polancan/esp32-wifi-timer/04_HARDWARE/SCHEMATICS_REFERENCE/schéma_zapojení_8kanálové_wi_fi_časomíry.png

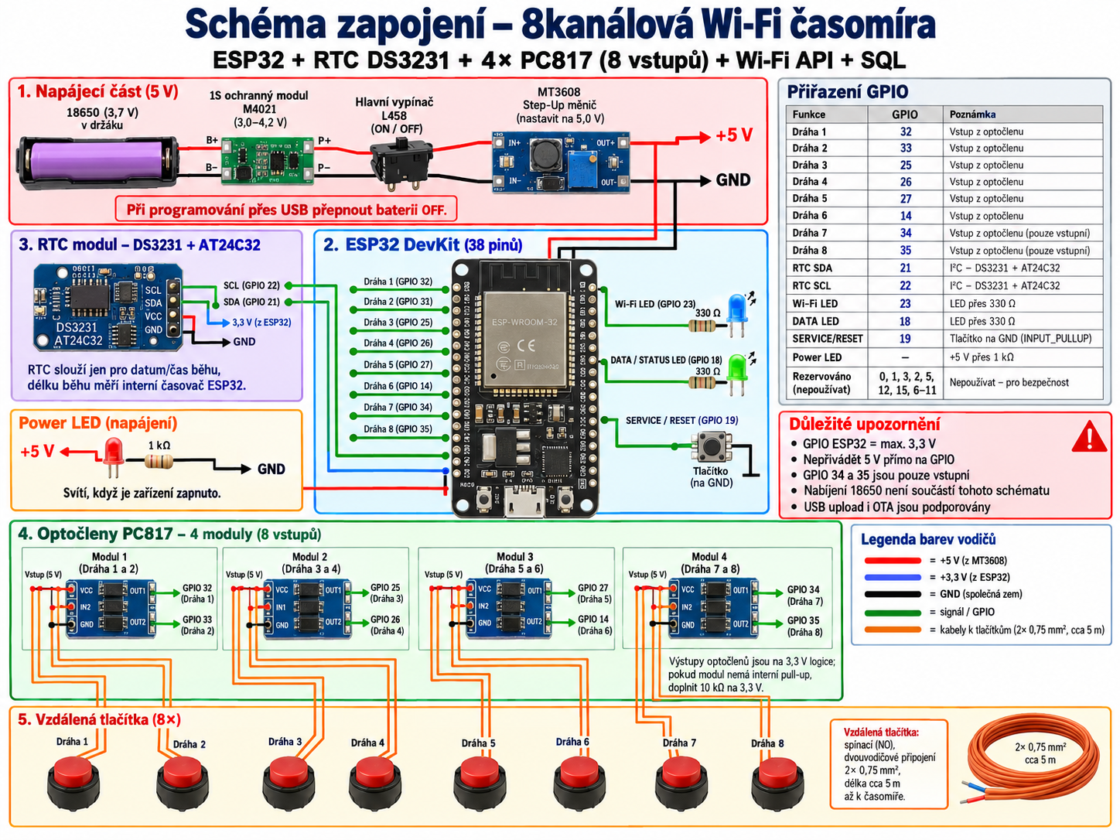
04_HARDWARE/SCHEMATICS_REFERENCE/schéma_zapojení_8kanálové_wi_fi_časomíry.png
