polancan/esp32-wifi-timer/04_HARDWARE/SCHEMATICS_REFERENCE/a_detailed_schematic_infographic_on_a_white_backgr.png

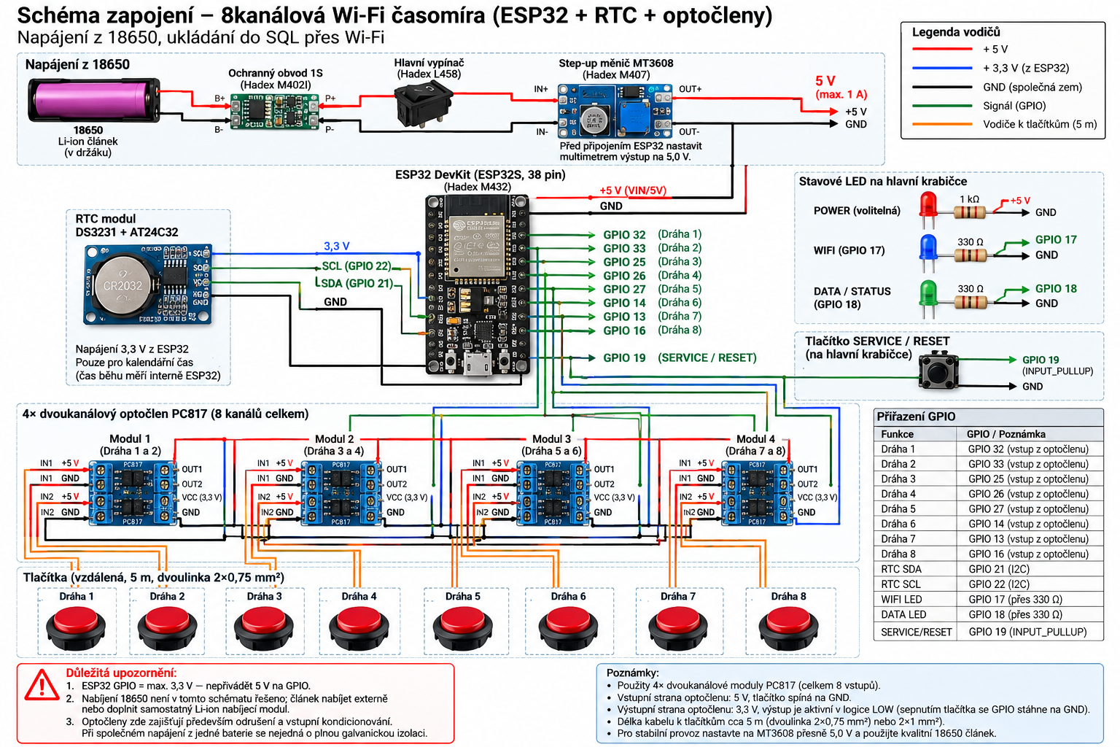
04_HARDWARE/SCHEMATICS_REFERENCE/a_detailed_schematic_infographic_on_a_white_backgr.png
