polancan/esp32-wifi-timer/02_FIRMWARE/README_FIRMWARE.md

# Firmware v1.3.1

Aktuální zdroj je v `SOURCE_v1.3.1/ESP32_Timer_Arduino/ESP32_Timer_Arduino.ino`.
Dokumentace: `../05_DOCUMENTATION/04_FIRMWARE_FLASHING.md`.

LittleFS se nepoužívá; offline výsledek je uložen v Preferences/NVS.
