polancan/esp32-wifi-timer/03_3D/README_3D.md

# 3D V1.7

Aktuální mechanika: PG7, hlavní zadní stěna 8× 12,5 mm.
GX16/M12 zatím není rozhodnuto. Finální materiál PETG.
Viz `../05_DOCUMENTATION/08_3D_MODELS.md`.
