polancan/esp32-wifi-timer/04_HARDWARE/PCB_REV_B_INTEGRATED/NETS.csv

Net | Pins | Domain | Note
USB_VBUS | J_USB.VBUS F_USB U_CHG.VBUS U_UART.VBUS | LOGIC | Never short to boosted 5V
USB_DP | J_USB.DP_A J_USB.DP_B D_USB U_UART.D+ | LOGIC | BQ25606 D+ remains NC
USB_DN | J_USB.DN_A J_USB.DN_B D_USB U_UART.D- | LOGIC | BQ25606 D- remains NC
USB_CC1 | J_USB.CC1 U_CC.CC1 | LOGIC | TUSB320I UFP termination
USB_CC2 | J_USB.CC2 U_CC.CC2 | LOGIC | TUSB320I UFP termination
BAT_PLUS | J_BAT.1 U_CHG.BAT R_BAT1.1 | LOGIC | Protected cell positive; exact pin depends connector
BAT_NTC | J_BAT.3 U_CHG.TS via bias network | LOGIC | Sensor bonded to battery
SYS | U_CHG.SYS U_3V3.VIN U_5V.VIN | LOGIC | 3.5-4.6V power path
LOGIC_GND | J_USB.GND J_BAT.2 U_CHG.GND U_3V3.GND U_5V.GND U_ESP.GND U_UART.GND U_RTC.GND | LOGIC | Must not join FIELD_GND
V3V3 | U_3V3.VOUT U_ESP.3V3 U_UART.VIO U_RTC.VCC J_EXP.1 R_PULL1-8.1 R_I2C1-2.1 | LOGIC | Wi-Fi current transient check
V5_LOGIC | U_5V.VOUT U_ISO.+VIN | LOGIC | Never short to USB VBUS
FIELD_5V | U_ISO.+VOUT U_FIELD.VIN | FIELD | Separate domain
FIELD_GND | U_ISO.-VOUT U_FIELD.GND U_OPTO1-8.LED_K | FIELD | Separate domain
FIELD_12_24V | U_FIELD.VOUT F_FIELD.IN | FIELD | Adjust 12-24V; clamp/limit requirement
FIELD_FUSED | F_FIELD.OUT J_LANE1-8.1 | FIELD | Eight contact outgoing terminals
BAT_ADC | R_BAT1.2 R_BAT2.1 C_BAT.1 U_ESP.GPIO36 | LOGIC | 100k/100k divider
I2C_SDA | U_ESP.GPIO21 U_RTC.SDA R_I2C1.2 | LOGIC | 3.3V
I2C_SCL | U_ESP.GPIO22 U_RTC.SCL R_I2C2.2 | LOGIC | 3.3V
UART_TX0 | U_ESP.GPIO1 U_UART.RXD | LOGIC | ESP transmitter
UART_RX0 | U_UART.TXD U_ESP.GPIO3 | LOGIC | ESP receiver
BOOT_EN | U_ESP.EN SW_RESET auto-program Q network | LOGIC | 10k to 3V3 and >=1uF to ground
BOOT_IO0 | U_ESP.GPIO0 SW_BOOT J_EXP.8 auto-program Q network | LOGIC | 10k pullup; strap
SERVICE | U_ESP.GPIO19 SW_SERVICE.1 | LOGIC | SW other pin ground
LED_WIFI | U_ESP.GPIO23 LED_WIFI.series_R | LOGIC | Active high
LED_DATA | U_ESP.GPIO18 LED_DATA.series_R | LOGIC | Active high
LANE1_RETURN | J_LANE1.2 R_LANE1.1 | FIELD | Dry contact return
LANE1_LED_A | R_LANE1.2 U_OPTO1.LED_A D_LANE1.K | FIELD | Reverse diode antiparallel
LANE1_GPIO | U_OPTO1.COLLECTOR R_PULL1.2 U_ESP.GPIO32 | LOGIC | Pressed LOW; emitter to LOGIC_GND
LANE2_RETURN | J_LANE2.2 R_LANE2.1 | FIELD | Dry contact return
LANE2_LED_A | R_LANE2.2 U_OPTO2.LED_A D_LANE2.K | FIELD | Reverse diode antiparallel
LANE2_GPIO | U_OPTO2.COLLECTOR R_PULL2.2 U_ESP.GPIO33 | LOGIC | Pressed LOW; emitter to LOGIC_GND
LANE3_RETURN | J_LANE3.2 R_LANE3.1 | FIELD | Dry contact return
LANE3_LED_A | R_LANE3.2 U_OPTO3.LED_A D_LANE3.K | FIELD | Reverse diode antiparallel
LANE3_GPIO | U_OPTO3.COLLECTOR R_PULL3.2 U_ESP.GPIO25 | LOGIC | Pressed LOW; emitter to LOGIC_GND
LANE4_RETURN | J_LANE4.2 R_LANE4.1 | FIELD | Dry contact return
LANE4_LED_A | R_LANE4.2 U_OPTO4.LED_A D_LANE4.K | FIELD | Reverse diode antiparallel
LANE4_GPIO | U_OPTO4.COLLECTOR R_PULL4.2 U_ESP.GPIO26 | LOGIC | Pressed LOW; emitter to LOGIC_GND
LANE5_RETURN | J_LANE5.2 R_LANE5.1 | FIELD | Dry contact return
LANE5_LED_A | R_LANE5.2 U_OPTO5.LED_A D_LANE5.K | FIELD | Reverse diode antiparallel
LANE5_GPIO | U_OPTO5.COLLECTOR R_PULL5.2 U_ESP.GPIO27 | LOGIC | Pressed LOW; emitter to LOGIC_GND
LANE6_RETURN | J_LANE6.2 R_LANE6.1 | FIELD | Dry contact return
LANE6_LED_A | R_LANE6.2 U_OPTO6.LED_A D_LANE6.K | FIELD | Reverse diode antiparallel
LANE6_GPIO | U_OPTO6.COLLECTOR R_PULL6.2 U_ESP.GPIO14 | LOGIC | Pressed LOW; emitter to LOGIC_GND
LANE7_RETURN | J_LANE7.2 R_LANE7.1 | FIELD | Dry contact return
LANE7_LED_A | R_LANE7.2 U_OPTO7.LED_A D_LANE7.K | FIELD | Reverse diode antiparallel
LANE7_GPIO | U_OPTO7.COLLECTOR R_PULL7.2 U_ESP.GPIO34 | LOGIC | Pressed LOW; emitter to LOGIC_GND
LANE8_RETURN | J_LANE8.2 R_LANE8.1 | FIELD | Dry contact return
LANE8_LED_A | R_LANE8.2 U_OPTO8.LED_A D_LANE8.K | FIELD | Reverse diode antiparallel
LANE8_GPIO | U_OPTO8.COLLECTOR R_PULL8.2 U_ESP.GPIO35 | LOGIC | Pressed LOW; emitter to LOGIC_GND
GPIO4_EXP | U_ESP.GPIO4 J_EXP.3 | LOGIC | Free GPIO
GPIO13_EXP | U_ESP.GPIO13 J_EXP.4 | LOGIC | Free GPIO
GPIO16_EXP | U_ESP.GPIO16 J_EXP.5 | LOGIC | Free GPIO
GPIO17_EXP | U_ESP.GPIO17 J_EXP.6 | LOGIC | Free GPIO
GPIO39_EXP | U_ESP.GPIO39 J_EXP.7 | LOGIC | Input only
GPIO0_EXP | U_ESP.GPIO0 J_EXP.8 | LOGIC | Boot strap
GPIO2_EXP | U_ESP.GPIO2 J_EXP.9 | LOGIC | Boot strap
GPIO5_EXP | U_ESP.GPIO5 J_EXP.10 | LOGIC | Boot strap
GPIO12_EXP | U_ESP.GPIO12 J_EXP.11 | LOGIC | Boot strap
GPIO15_EXP | U_ESP.GPIO15 J_EXP.12 | LOGIC | Boot strap
CC_OUT1 | U_CC.OUT1 U_ILIMLOGIC.IN1 | LOGIC | Current advertisement mode
CC_OUT2 | U_CC.OUT2 U_ILIMLOGIC.IN2 | LOGIC | Current advertisement mode
CHG_ILIM | U_ILIMLOGIC.OUT U_CHG.ILIM | LOGIC | Safe default current limit pending circuit
POWER_EN | SW_MAIN U_3V3.EN U_5V.EN | LOGIC | System off leaves charger attached to BAT; EN polarity to verify
