polancan/esp32-wifi-timer/04_HARDWARE/PCB_REV_A/NETS.csv

Net | Spoje | Domena | Poznamka
BAT_PLUS | BT1.plus|SW1.in|R_BAT_TOP.1 | LOGIC | merit pred boostem
BAT_SW | SW1.out|U_5V.vin | LOGIC | pojisteni clanku dle finalniho navrhu
GND_LOGIC | BT1.minus|U_5V.gnd|MOD_ESP.GND|U_ISO.pin2|U_ISO.pin3|U1-U8.emitor|R_BAT_BOTTOM.2|C_BAT.2|RTC1.GND|CI_ISO.minus | LOGIC | bez spoje na F_GND
V5_LOGIC | U_5V.vout|MOD_ESP.VIN_5V|U_ISO.pin22|U_ISO.pin23|CI_ISO.plus | LOGIC | USB or-ing vyresit v finalnim schematu
V3V3 | MOD_ESP.3V3|RP1-RP8.1|RTC1.VCC|R_SDA.1|R_SCL.1 | LOGIC | RTC I2C pull-up jen na 3V3
V5_FIELD | U_ISO.pin14|U_FIELD.vin|CO_ISO.plus | FIELD | izolovana 5V vetev
F_GND | U_ISO.pin16|U_FIELD.gnd|U1-U8.LED_K|D1-D8.A|TP_FGND|C_FIELD.minus|CO_ISO.minus|T1-T8.2 | FIELD | izolovana zem
F_FIELD_PLUS | U_FIELD.vout|F_FIELD.in|TP_F24|C_FIELD.plus | FIELD | pred jistenim
F_FIELD_FUSED | F_FIELD.out|J1-J8.pin1 | FIELD | 12 az 24V do kabelu
LANE1_RETURN | J1.pin2|R1.1|T1.1 | FIELD | TVS T1 DNP
LANE2_RETURN | J2.pin2|R2.1|T2.1 | FIELD | TVS T2 DNP
LANE3_RETURN | J3.pin2|R3.1|T3.1 | FIELD | TVS T3 DNP
LANE4_RETURN | J4.pin2|R4.1|T4.1 | FIELD | TVS T4 DNP
LANE5_RETURN | J5.pin2|R5.1|T5.1 | FIELD | TVS T5 DNP
LANE6_RETURN | J6.pin2|R6.1|T6.1 | FIELD | TVS T6 DNP
LANE7_RETURN | J7.pin2|R7.1|T7.1 | FIELD | TVS T7 DNP
LANE8_RETURN | J8.pin2|R8.1|T8.1 | FIELD | TVS T8 DNP
LANE1_LED_A | R1.2|U1.LED_A|D1.K | FIELD | D1 antiparalelne
LANE2_LED_A | R2.2|U2.LED_A|D2.K | FIELD | D2 antiparalelne
LANE3_LED_A | R3.2|U3.LED_A|D3.K | FIELD | D3 antiparalelne
LANE4_LED_A | R4.2|U4.LED_A|D4.K | FIELD | D4 antiparalelne
LANE5_LED_A | R5.2|U5.LED_A|D5.K | FIELD | D5 antiparalelne
LANE6_LED_A | R6.2|U6.LED_A|D6.K | FIELD | D6 antiparalelne
LANE7_LED_A | R7.2|U7.LED_A|D7.K | FIELD | D7 antiparalelne
LANE8_LED_A | R8.2|U8.LED_A|D8.K | FIELD | D8 antiparalelne
GPIO32 | U1.kolektor|RP1.2|MOD_ESP.GPIO32 | LOGIC | draha 1 aktivni LOW
GPIO33 | U2.kolektor|RP2.2|MOD_ESP.GPIO33 | LOGIC | draha 2 aktivni LOW
GPIO25 | U3.kolektor|RP3.2|MOD_ESP.GPIO25 | LOGIC | draha 3 aktivni LOW
GPIO26 | U4.kolektor|RP4.2|MOD_ESP.GPIO26 | LOGIC | draha 4 aktivni LOW
GPIO27 | U5.kolektor|RP5.2|MOD_ESP.GPIO27 | LOGIC | draha 5 aktivni LOW
GPIO14 | U6.kolektor|RP6.2|MOD_ESP.GPIO14 | LOGIC | draha 6 aktivni LOW
GPIO34 | U7.kolektor|RP7.2|MOD_ESP.GPIO34 | LOGIC | draha 7 aktivni LOW
GPIO35 | U8.kolektor|RP8.2|MOD_ESP.GPIO35 | LOGIC | draha 8 aktivni LOW
BAT_ADC | R_BAT_TOP.2|R_BAT_BOTTOM.1|MOD_ESP.GPIO36|C_BAT.1 | LOGIC | C_BAT volitelny
I2C_SDA | MOD_ESP.GPIO21|RTC1.SDA|R_SDA.2 | LOGIC | pull-up na 3V3 jen jednou
I2C_SCL | MOD_ESP.GPIO22|RTC1.SCL|R_SCL.2 | LOGIC | pull-up na 3V3 jen jednou
LED_WIFI | MOD_ESP.GPIO23|LED_WIFI.vstup | LOGIC | dle firmware a zapojeni LED
LED_DATA | MOD_ESP.GPIO18|LED_DATA.vstup | LOGIC | dle firmware a zapojeni LED
SERVICE | MOD_ESP.GPIO19|SW_SERVICE.vstup | LOGIC | overit klidovy stav
