polancan/esp32-wifi-timer/04_HARDWARE/hadex_casomira_KOMPLET.csv

M351 | 4
M407 | 1
M402I | 1
O275 | 16
N125C | 45
L458 | 1
L249E | 1
K269 | 1
K121 | 1
K117 | 1
H931 | 2
H937 | 1
H537U | 1
S018B | 1
I502 | 2
I857 | 1
