polancan/esp32-wifi-timer/04_HARDWARE/hadex_casomira_MINIMUM.csv

M351 | 4
M407 | 1
M402I | 1
O275 | 16
N125C | 45
L458 | 1
