polancan/esp32-wifi-timer/04_HARDWARE/SCHEMATICS_REFERENCE/blokové_schéma_wi_fi_časomíry.png

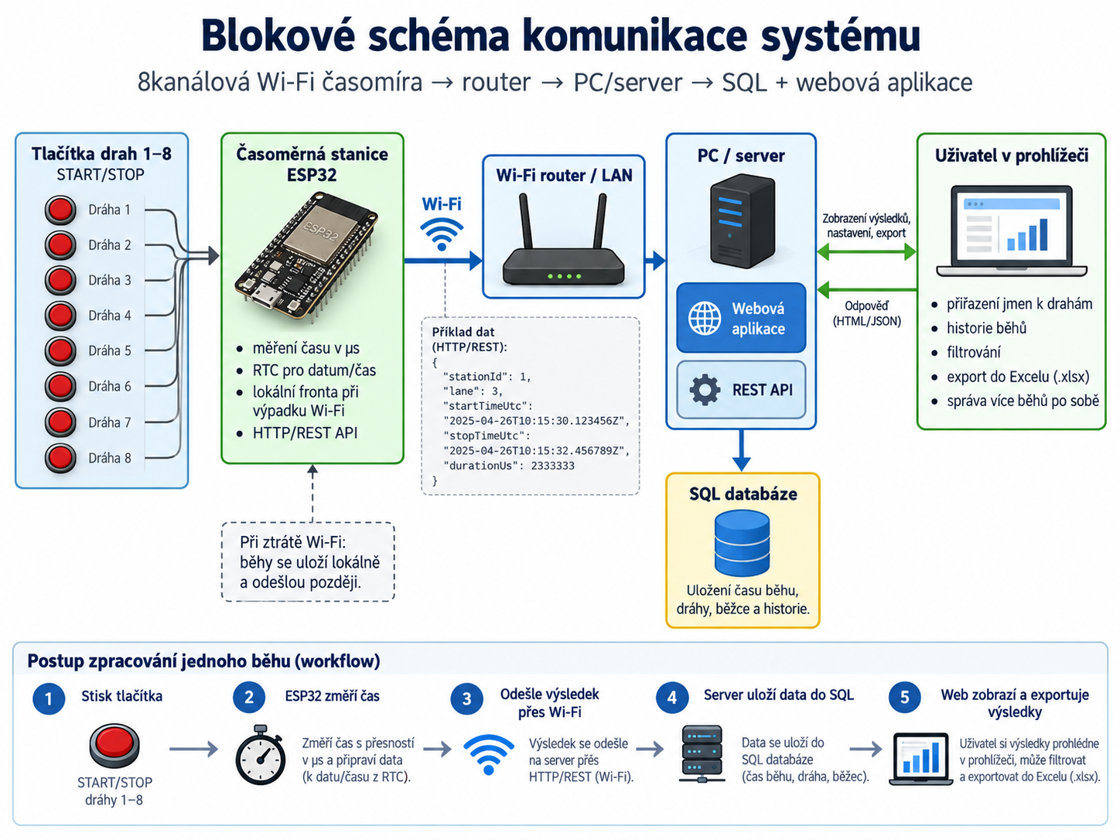
04_HARDWARE/SCHEMATICS_REFERENCE/blokové_schéma_wi_fi_časomíry.png
