polancan/esp32-wifi-timer/04_HARDWARE/SCHEMATICS_REFERENCE/stopky_esp32_s_8_drahami.png

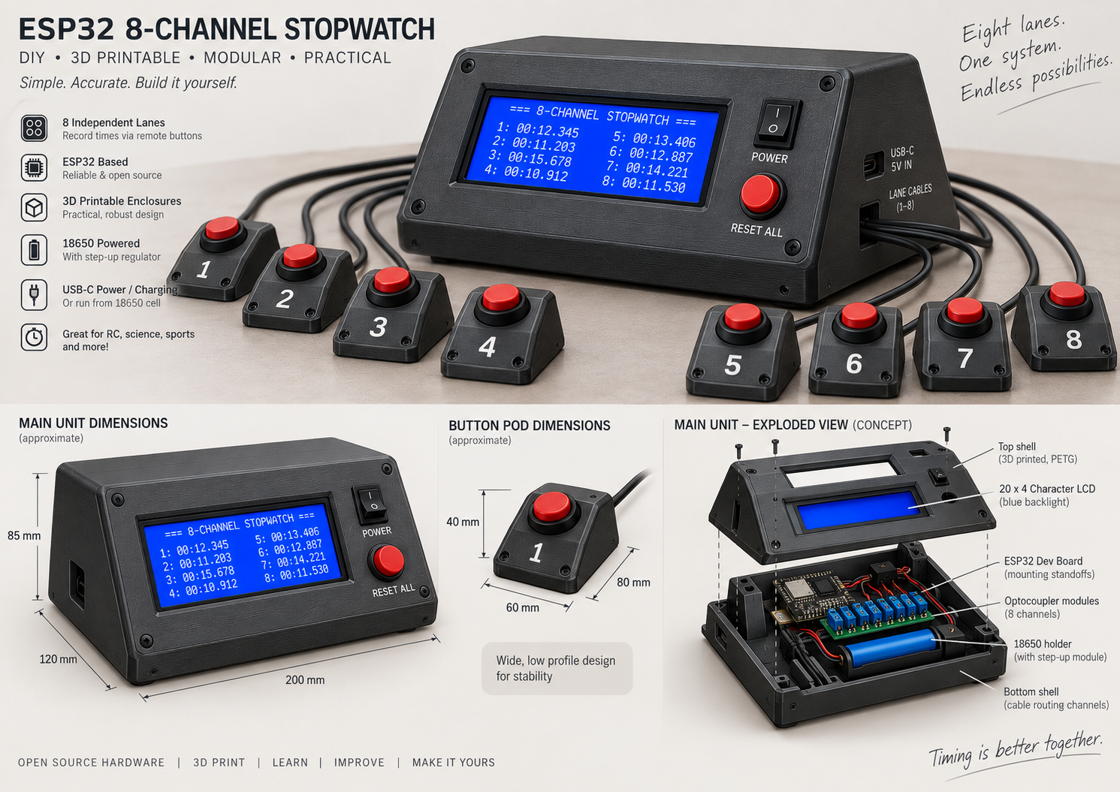
04_HARDWARE/SCHEMATICS_REFERENCE/stopky_esp32_s_8_drahami.png
