polancan/esp32-wifi-timer/05_DOCUMENTATION/UI_REFERENCE/selected_clean_layout_reference.png

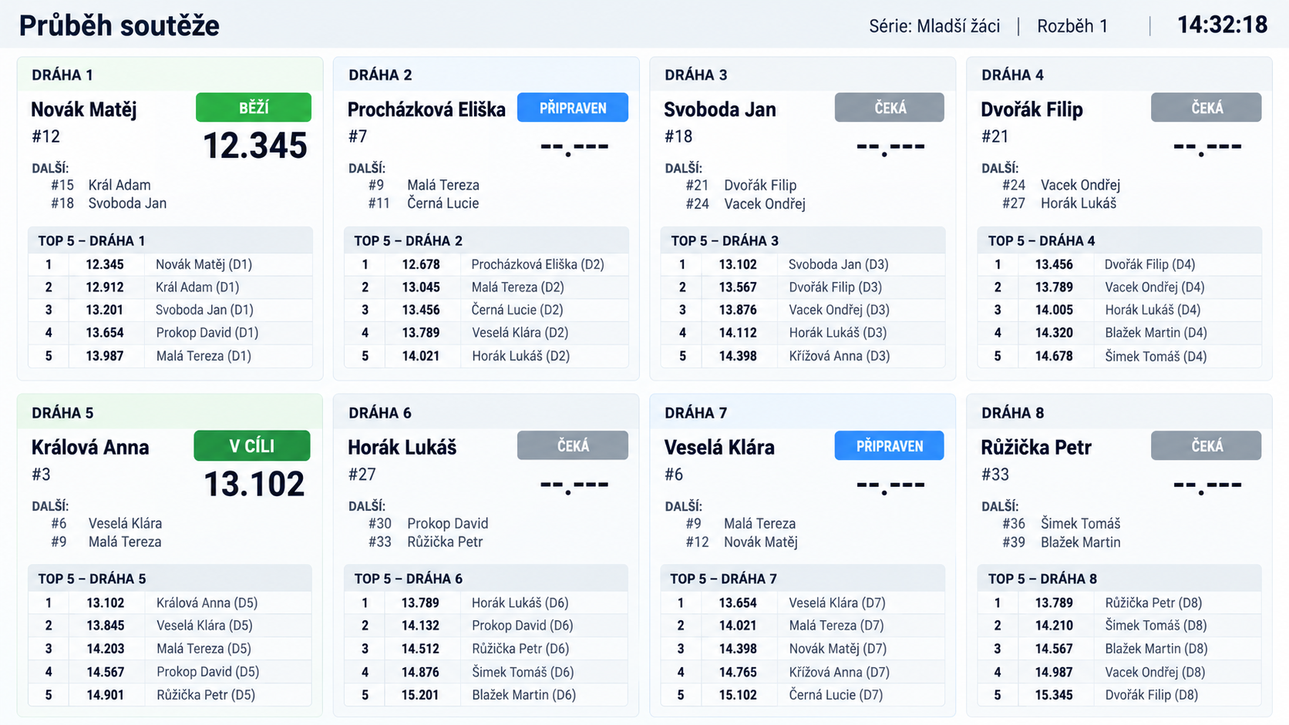
05_DOCUMENTATION/UI_REFERENCE/selected_clean_layout_reference.png
