polancan/esp32-wifi-timer/05_DOCUMENTATION/UI_REFERENCE/ui_variants_reference.png

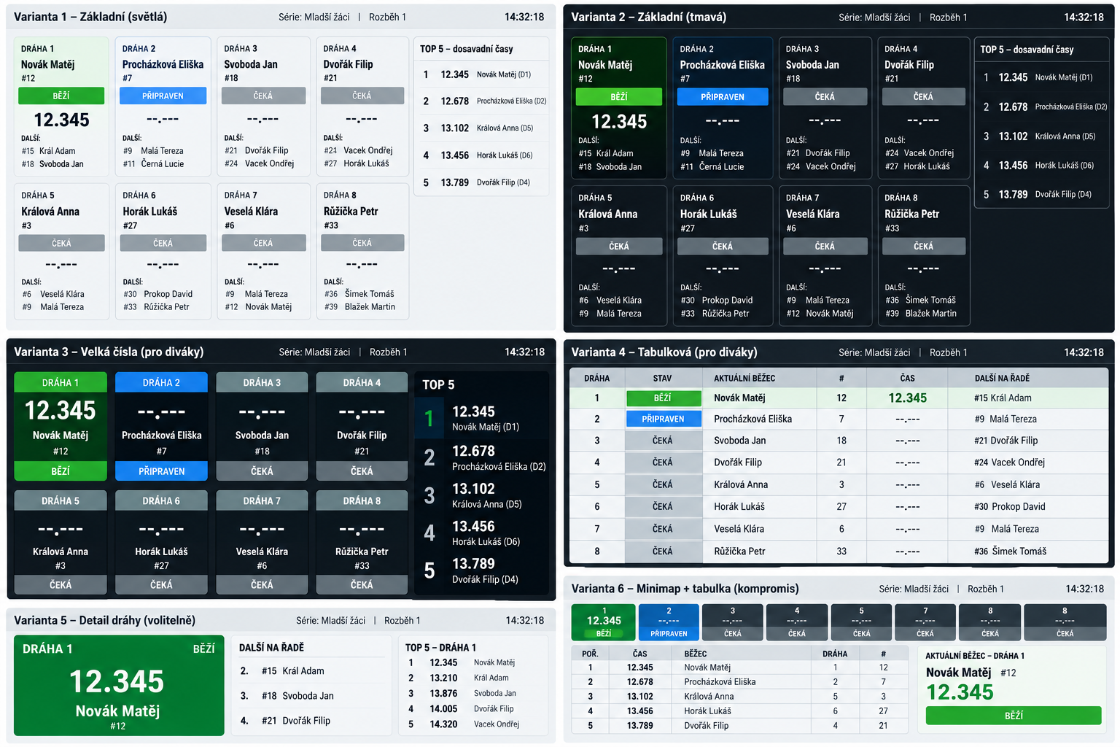
05_DOCUMENTATION/UI_REFERENCE/ui_variants_reference.png
