polancan/esp32-wifi-timer/04_HARDWARE/PCB_REV_B_INTEGRATED/BOM.csv

Ref | Qty | Part | Package | Status | DesignNote
J_USB | 1 | USB4085-GF-A | USB-C USB2.0 right-angle | CANDIDATE | Front edge; exact footprint/cutout required
U_CC | 1 | TUSB320IRWBR | X2QFN-12 | CANDIDATE | UFP Type-C CC current detection; VDD from USB VBUS independent of SW_MAIN; no PD
U_ILIMLOGIC | 1 | dual gate/analog switch network | TBD | DESIGN | OUT1/OUT2 safe ILIM selection default/1.5A/3A
D_USB | 1 | USB2.0 low-capacitance ESD array | TBD | SELECT | Protect D+ D- and CC
F_USB | 1 | USB VBUS input protection | TBD | SELECT | Coordinate with 500mA current limit and inrush
U_CHG | 1 | BQ25606RGET | VQFN-24 | CANDIDATE | 1S power-path charger; D+ D- charger pins floating
L_CHG | 1 | 1uH >= charger peak current | TBD | DESIGN | Select via TI datasheet and measured current
R_ILIM_NETWORK | 3 | TBD | 0603 | DESIGN | Select conservative USB input limits from TUSB320 OUT1/OUT2
R_ICHG | 1 | TBD | 0603 | DESIGN | Calculate for cell and system load
R_TS | 2 | TBD | 0603 | DESIGN | Thermistor bias network per NTC and TI window
J_BAT | 1 | keyed 3-pin >=3A | TBD | SELECT | Protected 18650 B+ B- NTC
SW_MAIN | 1 | latching low-current switch | TBD | SELECT | Controls regulator EN; charging remains active while off
BT1 | 1 | protected 18650 with 10k NTC | off-board | USER_PART | Cell selection/current/thermal data needed
U_3V3 | 1 | TPS63070 | VQFN | CANDIDATE | SYS to regulated 3.3V; reference design required
L_3V3 | 1 | TBD | TBD | DESIGN | Buck-boost magnetic
U_5V | 1 | TPS61088 | VQFN-20 | CANDIDATE | SYS to 5V >=1A
L_5V | 1 | TBD | TBD | DESIGN | Current saturation and efficiency verification
U_ISO | 1 | REC5-0505SRW/H4/A | DIP-24 | CANDIDATE | 5V/5V isolated 5W; footprint and EMC filter
U_FIELD | 1 | TPS55340RTE | WQFN-16 | CANDIDATE | Isolated 5V to adjustable 12-24V
L_FIELD | 1 | TBD | TBD | DESIGN | From 24V EVM but recalc 12-24V range
D_FIELD | 1 | 40V Schottky >= load | TBD | DESIGN | TPS55340 boost diode
RV_FIELD | 1 | 11k multiturn trimmer + 10k bottom + 187k top | TBD | DESIGN | Candidate 12.2-24.2V divider; tie wiper to used end, verify fault behavior
F_FIELD | 1 | field bus fuse/current limiter | TBD | DESIGN | Direct field short protection
U_ESP | 1 | ESP32-WROOM-32E-N4 | module 18x25.5mm | CHOSEN | Soldered module; antenna keepout
U_UART | 1 | CP2102N-A02-GQFN28 | QFN-28 | CANDIDATE | USB2.0 UART DTR RTS for auto boot
Q_BOOT1-Q_BOOT2 | 2 | NPN transistor per Espressif DevKitC | SOT-23 | DESIGN | Correct DTR/RTS truth table
SW_BOOT-SW_RESET | 2 | momentary tactile | TBD | SELECT | GPIO0 and EN to ground
U_RTC | 1 | DS3231SN | SOIC-16 300mil | CANDIDATE | 3.3V I2C with coin backup
BT_RTC | 1 | CR2032 holder + cell | TBD | SELECT | VBAT only; no charge path
R_I2C1-R_I2C2 | 2 | 4.7k 1% | 0603 | VALUE_SET | One pull-up per I2C line to 3.3V
LED_WIFI-LED_DATA | 2 | status LED | 0603 | SELECT | Active high via current-limit resistor
SW_SERVICE | 1 | momentary tactile | TBD | SELECT | GPIO19 to GND
U_OPTO1-U_OPTO8 | 8 | EL817C-G | DIP-4 | CANDIDATE | One per lane; verify CTR at 12V
R_LANE1-R_LANE8 | 8 | 2.2k 0.5W | 1206 or larger | VALUE_SET | At 24V approx 0.236W; thermal check
R_PULL1-R_PULL8 | 8 | 10k | 0603 | VALUE_SET | GPIO pullups 3.3V
D_LANE1-D_LANE8 | 8 | 1N4148 | SOD-123 | VALUE_SET | Antiparallel opto LED
J_LANE1-J_LANE8 | 8 | 2-pin 3.5mm terminal | TBD | SELECT | Eight dry-contact cable pairs
J_EXP | 1 | 2x7 2.54mm header | THT | CHOSEN | Unused GPIO breakout incl boot pins
R_BAT1-R_BAT2 | 2 | 100k | 0603 | VALUE_SET | Battery ADC divider GPIO36
C_BAT | 1 | 100nF | 0603 | PROVISIONAL | ADC low-pass; measure settling
TP_TEST | 8 | testpoint | TBD | DESIGN | USB5 SYS BAT 3V3 5V field5 field24 fieldGND
