polancan/esp32-wifi-timer/03_3D/STL_PRINT_ONLY_V1.7/main_tray_v1_7.stl

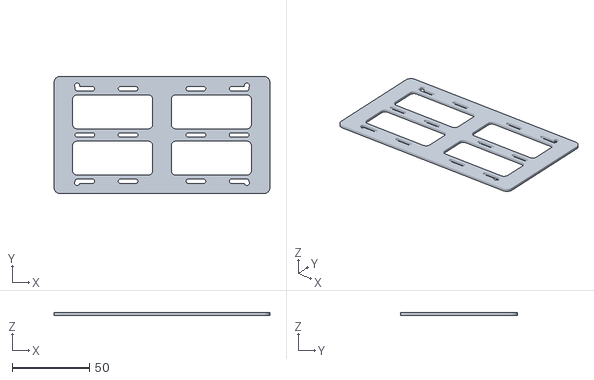
[picture p7: CAD file, 2026-10-10]
03_3D/STL_PRINT_ONLY_V1.7/main_tray_v1_7.stl
140.0 x 76.0 x 1.80
