polancan/esp32-wifi-timer/03_3D/SOURCE_V1.7/stopwatch_3d_models_v1_7_source/STL/main_lid_v1_7.stl

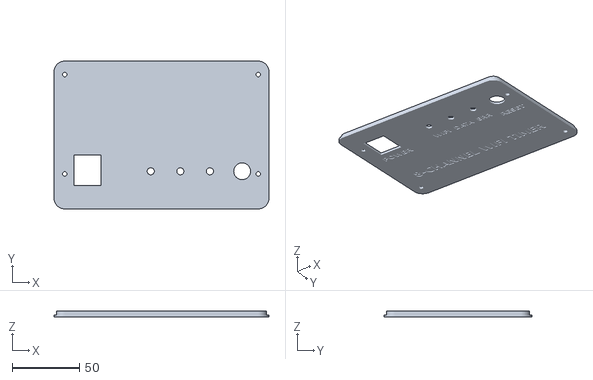
[picture p8: CAD file, 2026-10-10]
03_3D/SOURCE_V1.7/stopwatch_3d_models_v1_7_source/STL/main_lid_v1_7.stl
160.0 x 110.0 x 4.80
