polancan/esp32-wifi-timer/03_3D/STL_PRINT_ONLY_V1.7/main_base_v1_7.stl

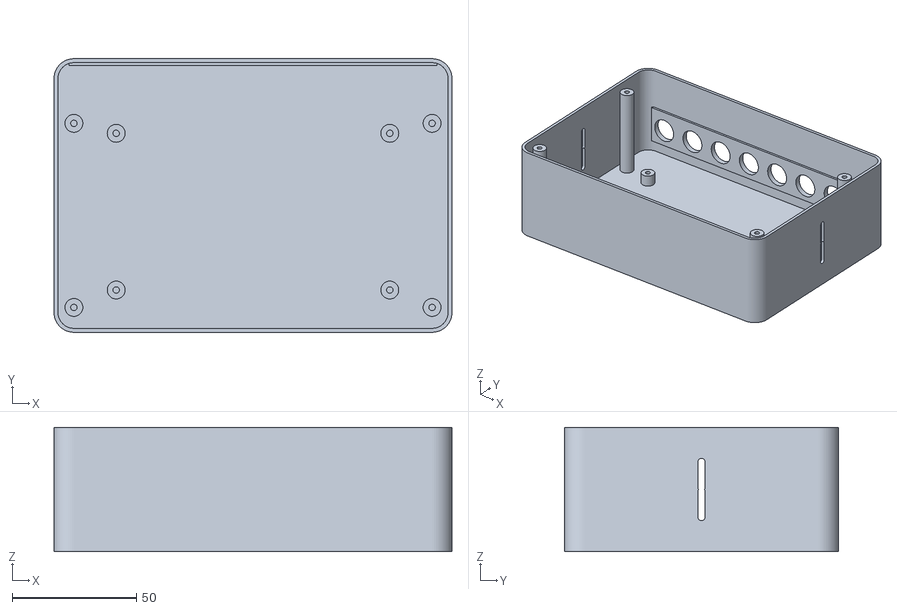
[picture p9: CAD file, 2026-10-10]
03_3D/STL_PRINT_ONLY_V1.7/main_base_v1_7.stl
160.0 x 110.0 x 50.0
