polancan/esp32-wifi-timer/03_3D/SOURCE_V1.7/stopwatch_3d_models_v1_7_source/STL/button_lid_lane5_v1_7.stl

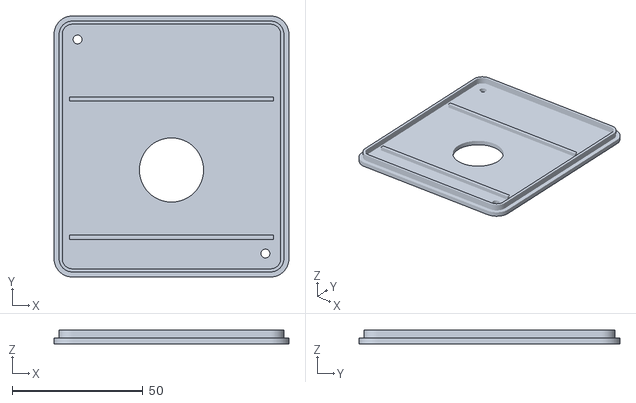
[picture p10: CAD file, 2026-10-10]
03_3D/SOURCE_V1.7/stopwatch_3d_models_v1_7_source/STL/button_lid_lane5_v1_7.stl
90.0 x 100.0 x 5.20
