polancan/esp32-wifi-timer/03_3D/STL_PRINT_ONLY_V1.7/button_base_lane2_v1_7.stl

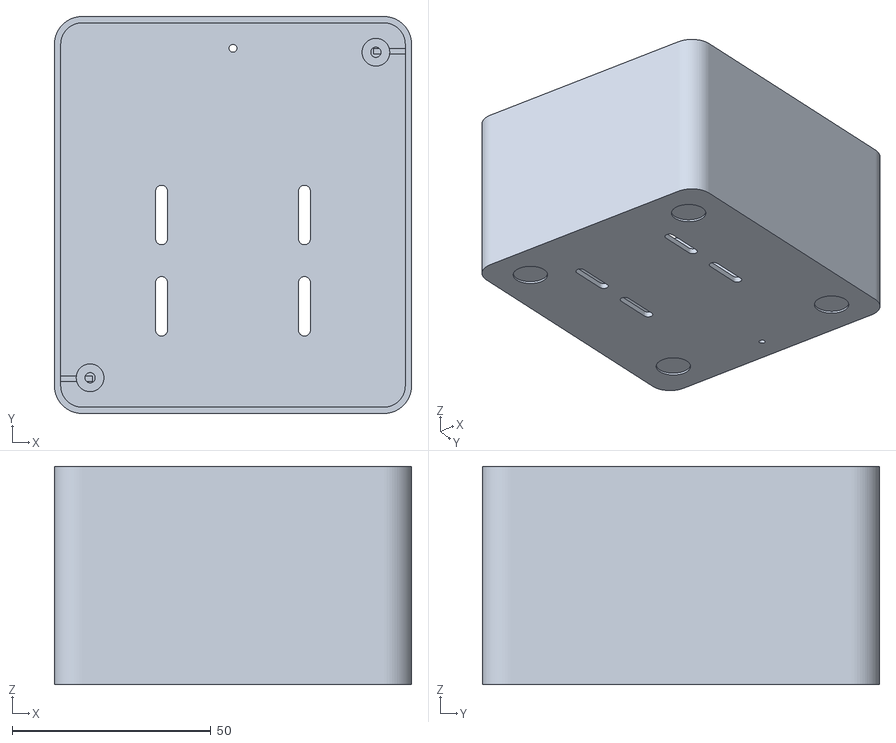
[picture p11: CAD file, 2026-10-10]
03_3D/STL_PRINT_ONLY_V1.7/button_base_lane2_v1_7.stl
90.0 x 100.0 x 55.0
