polancan/esp32-wifi-timer/03_3D/SOURCE_V1.7/stopwatch_3d_models_v1_7_source/Reference/collision_check_v1_7.scad

include <../stopwatch_enclosures_v1_7.scad>
if (TEST=="button") intersection(){ button_base(); translate([0,0,bh]) button_lid_assembly(1,false); }
else if (TEST=="main") intersection(){ main_base(); translate([0,0,mh]) main_lid_assembly(false); }
