polancan/esp32-wifi-timer/03_3D/SOURCE_V1.7/stopwatch_3d_models_v1_7_source/Reference/main_assembly_v1_7.scad

include <../stopwatch_enclosures_v1_7.scad>
main_base();
translate([0,0,mh]) main_lid_assembly(false);
translate([10,10,floor_t+6]) main_tray();
