polancan/esp32-wifi-timer/(list of files, cad)

Other CAD files:
03_3D/STL_PRINT_ONLY_V1.7/button_lid_lane1_v1_7.stl
03_3D/SOURCE_V1.7/stopwatch_3d_models_v1_7_source/STL/button_lid_lane2_v1_7.stl
03_3D/SOURCE_V1.7/stopwatch_3d_models_v1_7_source/STL/button_lid_lane3_v1_7.stl
03_3D/SOURCE_V1.7/stopwatch_3d_models_v1_7_source/STL/button_lid_lane7_v1_7.stl
03_3D/SOURCE_V1.7/stopwatch_3d_models_v1_7_source/STL/button_lid_lane8_v1_7.stl
03_3D/STL_PRINT_ONLY_V1.7/button_lid_lane7_v1_7.stl
03_3D/SOURCE_V1.7/stopwatch_3d_models_v1_7_source/STL/button_lid_lane4_v1_7.stl
03_3D/STL_PRINT_ONLY_V1.7/button_lid_lane6_v1_7.stl
03_3D/SOURCE_V1.7/stopwatch_3d_models_v1_7_source/STL/button_lid_lane6_v1_7.stl
03_3D/STL_PRINT_ONLY_V1.7/button_lid_lane3_v1_7.stl
03_3D/SOURCE_V1.7/stopwatch_3d_models_v1_7_source/STL/button_lid_lane1_v1_7.stl
03_3D/STL_PRINT_ONLY_V1.7/button_lid_lane4_v1_7.stl
03_3D/STL_PRINT_ONLY_V1.7/button_lid_lane8_v1_7.stl
03_3D/STL_PRINT_ONLY_V1.7/button_lid_lane2_v1_7.stl
