polancan/esp32-wifi-timer/06_TEST_DATA/README.md

# Testovací data

`startlist_lane1_10.csv` obsahuje 10 testovacích běžců pro dráhu 1 ve formátu `Jméno;Dráha;Pořadí`.
