polancan/esp32-wifi-timer/06_TEST_DATA/startlist_lane1_10.csv

Jméno | Dráha | Pořadí
Běžec 01 | 1 | 1
Běžec 02 | 1 | 2
Běžec 03 | 1 | 3
Běžec 04 | 1 | 4
Běžec 05 | 1 | 5
Běžec 06 | 1 | 6
Běžec 07 | 1 | 7
Běžec 08 | 1 | 8
Běžec 09 | 1 | 9
Běžec 10 | 1 | 10
