polancan/esp32-wifi-timer/02_FIRMWARE/SOURCE_v1.3.1/CHANGELOG_v1_3_1.txt

ESP32 Timer firmware v1.3.1

Fix:
- ArduinoJson compatibility: firmware now compiles with ArduinoJson 6.x and 7.x.
- No LittleFS dependency; offline results continue to use Preferences/NVS.
- No pinout or server API changes from v1.3.0.
