polancan/esp32-wifi-timer/02_FIRMWARE/SOURCE_v1.3.1/CHANGELOG_v1_3.txt

FW v1.3.0
=========
- odstraněn LittleFS
- offline ukládání převedeno na Preferences / NVS
- maximálně 1 trvale uložený pending výsledek na každou z 8 drah
- zachován DeviceEventId při retry
- zachováno OTA, RTC/NTP, baterie GPIO36, heartbeat a bezpečné zamykání dráhy
