polancan/esp32-wifi-timer/(commit log)

2026-10-10 Upload reviewed ESP32 project for initial import
2026-10-10 Import reviewed ESP32 project sources, models and documentation
    [button_assembly_v1_7.scad, button_base_lane1_v1_7.stl, button_base_lane2_v1_7.stl, button_base_lane3_v1_7.stl, button_base_lane4_v1_7.stl, button_base_lane5_v1_7.stl, button_base_lane6_v1_7.stl, button_base_lane7_v1_7.stl]
2026-10-11 Add PCB Rev A preparation folder
2026-10-11 Add PCB Rev A electrical and manufacturing preparation
    [BOM.csv, NETS.csv]
2026-10-11 Link PCB Rev A preparation from hardware README
    Added information about PCB Rev A and its specifications.
2026-10-11 Document PCB Rev A preparation in project README
    Added information about PCB Rev A for 30pin DevKit V1.
2026-10-11 Start integrated PCB Rev B design folder
    Added a .gitkeep file to maintain directory structure for PCB design.
2026-10-11 Add integrated ESP32 PCB Rev B design package
    Document soldered WROOM-32E architecture, USB-C programming and charge power path, 8 isolated 12–24V inputs, spare GPIO header, BOM, nets, placement and release gates. Draft only; no fabrication files yet.
    [BOM.csv, NETS.csv]
2026-10-11 Point hardware docs to integrated PCB Rev B
    Updated hardware documentation to reflect changes in PCB revisions and source references.
2026-10-11 Link integrated PCB Rev B from project README
    Updated PCB documentation for Rev B and clarified design status.
2026-10-11 Document Rev B collisions and draft electrical schematic
    Mark three blocking placement collisions; add four-sheet wiring draft and USB-C current-limit dependency. Routing and fabrication remain on hold pending native CAD, footprints and ERC/DRC.
    [BOM.csv]
